kai054631/ESP32_wheel_bot/progress.md

# Progress Log

## 2026-08-08 — Course started
- Set up course scope, hardware (ESP32-S3 + GY-85 + TB6612 + 2 motors w/ encoders, diff drive), toolchain (PlatformIO), teaching style (Socratic/guided lookup).
- Stage 1 goal defined: fused pose (x, y, θ) estimate from encoders + IMU.
- Toolchain switched to native ESP-IDF (already installed) instead of PlatformIO.
- Board: ESP32-S3-DevKitC clone, two USB-C ports — one wired to the S3's native USB peripheral (idVendor=303a, "USB JTAG/serial debug unit"), one to an onboard WCH USB-serial chip (idVendor=1a86, PID 55d3, "USB Single Serial").
- **Gotcha found & fixed:** `/dev/ttyACM*` never appeared on either port because `cdc_acm` was blacklisted system-wide in `/etc/modprobe.d/blacklist-qcserial.conf` (leftover from [[jz01-openstick-flash]], now finished). Removed the `blacklist cdc_acm` line, `sudo modprobe cdc_acm` — `/dev/ttyACM0` now appears (bound to the 1a86:55d3 WCH chip's port; ch341/ch343 drivers were never actually needed since cdc_acm's alias table already covers that PID).
- Found existing half-done work at ~/Documents/PlatformIO/Projects/wheel_robot: a PlatformIO/Arduino project (platformio.ini targets esp32-s3-devkitc1-n8r8) with src/main.cpp already declaring TB6612 pins (PWMA=4, AIN2=5, AIN1=6, STBY=7, BIN1=15, BIN2=16, PWMB=17, GND=18), encoder pins (enAA=8, enAB=3, enBA=46, enBB=9), and GY-85 I2C pins (sda=11, scl=10) — motor speed/interrupt code commented out, nothing implemented yet. Also had a cloned reference repo `esp-idf-gy85` nested inside it (ready-made ADXL345/ITG3200/HMC5883L/I2Cdev drivers + MadgwickAHRS/Kalman fusion, WiFi streaming examples).
- Decision: redo firmware in native ESP-IDF (porting the pin assignments above, not the Arduino code itself); esp-idf-gy85 set aside as an answer-key only, not to be copied from directly — GY-85 drivers to be written from scratch in Modules 2–3.
- Moved everything into the course folder: `~/robot_learner/reference/wheel_robot_platformio/` (old project) and `~/robot_learner/reference/esp-idf-gy85/` (reference repo).
- Next: Module 0 continued — create a fresh ESP-IDF hello_world project (e.g. `~/robot_learner/firmware/`) and verify `idf.py build/flash/monitor` round-trip on /dev/ttyACM0.

## 2026-08-08 (cont.) — Tutorial series planning
- User asked for a 1-by-1 tutorial series (60-90 min each) ending in the robot driving as a 2-wheel differential robot, before localization work.
- Plan written and approved: reorders syllabus to drive-first — T1 ESP-IDF bring-up, T2 wiring/pin/power audit, T3 TB6612+LEDC per-wheel, T4 open-loop drive(v,ω) [robot runs = milestone], T5 encoders (PCNT), T6 tick→metres calibration, T7 closed-loop PI + square capstone. IMU/GY-85/fusion deferred to after T7.
- **Finding: ESP-IDF was never actually installed on this Linux box.** VS Code Espressif extension present but its globalStorage never initialized; settings.json had stale Windows paths (d:\ESPTOOLS\...) synced from another machine; only export.sh on disk belongs to PlatformIO's bundled framework-espidf (not to be reused as IDF_PATH — it's stripped down). Cleared the stale idf.pythonInstallPath/idf.gitPathWin keys from settings.json (backup at settings.json.bak-robotlearner).
- Started headless install via `~/.espressif/eim_gui/eim install -t esp32s3 -i v5.3.2` (this is infra, driven by tutor not Socratic). First attempt failed: missing system prereqs flex/bison/gperf/ccache. Wrote `fix_idf_prereqs.sh` (apt install, needs sudo) for user to run themselves.
- Next: user runs fix_idf_prereqs.sh, then re-launch eim install in background; once idf.py --version works, write and hand over Tutorial 1 (~/robot_learner/tutorials/t01-*.html).

## 2026-08-09 — ESP-IDF install running
- User ran fix_idf_prereqs.sh: flex/bison/gperf/ccache confirmed installed via dpkg.
- Relaunched `eim install -t esp32s3 -i v5.3.2 -n true --cleanup true` in background (log: idf_install.log). Prereqs check passed, mirrors selected (github.com, pypi.org), cloning esp-idf v5.3.2 now.
- Board currently unplugged (no /dev/ttyACM0) — not blocking, install doesn't need the board.
- Next: poll idf_install.log until done, verify `idf.py --version`, then write Tutorial 1 HTML page.

## 2026-08-09 (cont.) — ESP-IDF install finished, Tutorial 1 unblocked
- eim install completed successfully: "You have successfully installed ESP-IDF" (ESP-IDF v5.3.2, esp32s3 target, ~5.5 min total).
- Verified: `source ~/.espressif/tools/activate_idf_v5.3.2.sh` then `idf.py --version` → "ESP-IDF v5.3.2-dirty" (dirty suffix is harmless, normal for shallow submodule clone). IDF_PATH set correctly.
- One non-fatal install error: couldn't copy OpenOCD udev rules to /etc/udev/rules.d (needs sudo) — irrelevant for now (flashing over WCH UART/cdc_acm, not JTAG); revisit only if JTAG debugging is needed later.
- Tutorial 1 (~/robot_learner/tutorials/t01-esp-idf-bringup.html) is now fully unblocked — toolchain ready, board at /dev/ttyACM0 (when plugged in).

## 2026-08-15 → 2026-09-05 — Firmware stages and the new PCB (from git log)
- 08-15 initial backup of firmware, tutorials, docs, PCB snapshot. Tutorials in the repo: t01, t05–t08 (t02–t04 are not there).
- 08-23 `GY85_Check`: I2C bring-up, then live data from all three sensors. The "magnetometer" is a QMC5883L clone (address 0x0D), not an HMC5883L.
- 08-31 `Motor_Drive_With_IDF` tried on DRV8833, then went back to TB6612FNG on the new board.
- 09-05 combined bring-up test on the new PCB pinout: both motors both ways, both encoders, GY-85 live data, battery voltage sense. Pin map is in `pins.txt`.

## 2026-10-15 — Encoders to 4x, PWM→rpm table, first P speed control
Code lives in `firmware/Motor_Drive_With_IDF/main/main.c` (main checkout, not committed yet).
- **Encoder was only 2x decode.** Each PCNT unit had one channel. Hand-turning the wheel one turn gave ~957 ticks (expected 990 = 11 PPR × 2 × 45). Fix: a second channel per motor on the same unit (edge/level pins swapped). Rule: both channels of a motor use level action (KEEP, INVERSE); their edge actions are swapped; motor B is mirrored so its actions are the opposite of motor A.
- Motor A now gives **1980 ticks per wheel turn** (11 PPR × 4 × 45), checked by hand. Motor B has the same two-channel setup and moved in the same direction as A; its ticks per turn were not reported — **still to verify**.
- Encoder pins are swapped in the `#define`s (A: 11/10, B: 13/12) so forward counts **positive**. The names still say "phase A/B" — they are swapped on purpose.
- Speed: `rpm = delta / 0.02 s / 1980 × 60`, `m/s = rpm × π × 0.065 / 60`. One tick per 20 ms is **1.5 rpm**, so steady readings jump by about ±1.5–2.5 rpm. That is quantisation, not instability.
- **PWM → rpm, wheel in the air, 12.55 V** (steps of 5 %): 0, 5, 10 % → 0 rpm; 15 % → 21.2; 30 % → 50; 50 % → 89.4; 75 % → 137.9; 100 % → 190.9 rpm (0.649 m/s). Dead zone is between 10 and 15 %. Line fit above the dead zone: **rpm ≈ 2.01 × PWM − 9.9** (check: 50 % gives 90.5, measured 89.4). The `rpm/pwm` column is not constant because of the negative offset; the slope is. Floor (loaded) table not measured yet.
- **Battery sense** (GPIO14, ADC2 ch3): divider 100k/22k → ×5.545. The plain `raw/4095 × 3.3 × 5.545` read about 8 % low (10.5 V on an 11.5 V pack, 11.59 V on 12.6 V). A gain of **1.09** fixes it to about ±0.05 V. The IDF curve-fit calibration (used in the 09-05 test) is still the better option.
- **Serial gotcha:** the native USB port (303a, "USB JTAG serial debug unit") is output-only (console is UART0 with USB-JTAG as secondary). Keyboard input in `idf.py monitor` only works on the other USB port (WCH, 1a86). "Writing to serial is timing out" means wrong port.
- **P control with feed-forward:** `pwm = (target + 9.9) / 2.01 + Kp × (target − rpm)`. Hold-the-wheel-then-release test at 40 rpm, 20 ms per line:
  - Kp 0.35: 36 rpm after ~80 ms, no real overshoot.
  - Kp 0.7: ~100 ms, no real overshoot.
  - Kp 1.0: ~80 ms, but overshoots to 45.5 rpm (~14 %) and rings for ~160 ms.
  - Use **Kp ≈ 0.5**. Loop gain = Kp × 2.01; above ~1 you get overshoot. A bigger Kp also makes the 1-tick noise bigger.
  - With the wheel in the air the feed-forward is already almost exact, so the steady error is < 1 rpm. Under load P-only will leave an error → add the I term (t08).
- Two false alarms: the "restart at PWM ≥ 45" was a key press (`0` set PWM to 0), not a reset. The random GPIO 48 RGB LED is a floating pin (not fixed yet: set it as output, low).
- **Open items:** verify motor B (1980 per turn, sign of +PWM vs +rpm — if opposite, the loop runs away), measure the PWM→rpm table on the floor, PI controller (t08), battery check (read every cycle, hysteresis, command 0 when low instead of sleeping), wrap handling for the PCNT counter (±32767, ~5 s at full speed), tidy `main.c` (per-motor struct, named constants, `motor.c/h`).

## 2026-10-16 to 2026-10-25 — Speed loop in motor.c, odometry, Wi-Fi, live map
Code is in `firmware/Motor_Drive_With_IDF/main/`. Style rule from 2026-10-25: write English in ASD-STE100.

**Speed loop (motor.c, motor.h)**
- `motor_t` holds the pins, the PCNT unit, and the state of one motor. `motor_drive()` replaces the two copies of `motorMove`.
- `motor_update()` does the full cycle: read the count, handle the PCNT wrap, calculate rpm, add feed-forward, P, and I terms, clamp, lift the dead zone, and drive the motor.
- Feed-forward: `(|target| + 9.9) / 2.01`, with the sign of the target. Negative targets work.
- Dead zone: a PWM value between 0 and 15 (or between -15 and 0) is set to 15 (or -15).
- The integral clamp is ±10. A clamp of ±30 gave an 80 % overshoot at start-up.
- `motor_kp` and `motor_ki` are shared globals (one set of gains for both motors).
- Motor A is the LEFT wheel. Motor B is the RIGHT wheel. The names follow the PCB silkscreen. Both encoders give 1980 ticks per turn.
- A target of 20 rpm or less is limited by the dead zone. The wheel cannot hold a speed below about 21 rpm.

**Odometry (odom.c, odom.h)**
- One tick is `pi * D / 1980` m. The wheel diameter D is 68.5 mm (measured). The old code used 65 mm.
- `d = (dL + dR) / 2` and `dtheta = (dR - dL) / L`. The code uses the new theta to update x and y.
- Test: a 300 mm push read 311 mm (3.7 % too high). After more tests the distance is accurate. Heading drift was small (y = 2 mm, theta = -0.4 deg).

**Wi-Fi (net.c, net.h)**
- Wi-Fi station mode plus one TCP server on port 3333. The robot serves ONE client only.
- `net_printf()` and `net_getc()` do not block. The control loop never waits for the network.
- The Wi-Fi name and password are in `wifi_secret.h`. This file is in `.gitignore`. Do not commit it.
- Warning: ADC2 (battery sense, GPIO 14) and Wi-Fi share hardware. `adc_oneshot_read` can return `ESP_ERR_TIMEOUT`. The code must not stop on this error.

**Live map (tools/robot_map.py)**
- It reads the Odom lines from the TCP stream. It draws the trail and the robot outline on an x-y map.
- Keys w, a, s, d, and space go to the robot. Use this tool instead of `nc`.
- Run `python3 tools/robot_map.py --demo` to test it without the robot.

**Robot size (measured 2026-10-25)**
- Width over the outer faces of the wheels: 209 mm. Gap between the wheels: 157 mm.
- Each wheel is 26 mm wide. The track width (centre to centre) is therefore 157 + 26 = **183 mm**.
- Length: 213 mm. The drive wheels are at the front. The dead (caster) wheel is at the rear.
- The odometry point is the midpoint of the drive axle.
- `TRACK_WIDTH` in `odom.h` was 0.157 (the gap, not the track width). Change it to 0.183. Then calibrate: turn the robot one full turn on the floor. The theta reading must be 360 deg.
- A turn on the spot sweeps the rear of the robot through a circle of about 0.5 m diameter.

**Open items**
1. Dead-man timeout: the robot must stop when no key arrives (use 0.7 s).
2. `drive(v, omega)`, the `D` and `T` commands (go a distance, turn an angle), and the `p0.01` command (set Kp).
3. Handle the ADC2 error when Wi-Fi is on.
4. Calibrate `TRACK_WIDTH` on the floor (3 turns, take the average).
5. Measure the PWM-to-rpm table on the floor.

## 2026-10-25 (later) — Track width calibration, first results
Goal: find the effective track width L. The odometry uses `dtheta = (dR - dL) / L`. A wrong L gives a wrong turn angle by the same ratio.

**Measured sizes:** the gap between the wheels is 157 mm. Each wheel is 26 mm wide. So the track width from the sizes is 183 mm. The code first used `TRACK_WIDTH 0.1832`.

**Test 1: A = 35 rpm, B = 0 (left wheel drives, robot turns clockwise around the right wheel). Odometry was reset.**
- The robot turned about one full turn (set by eye). The theta reading was **-378.1 deg**. The position was x = 0.029 m, y = 0.005 m.
- Check: the robot turned 18 deg more than one turn. The center then moves `L * sin(9 deg) = 0.1832 * 0.156 = 0.029 m`. This matches x. The odometry is consistent inside.

**Test 2: B = 35 rpm, A = 0 (right wheel drives, robot turns counter-clockwise around the left wheel). Odometry was NOT reset.**
- The reading after the test was theta = -6.6 deg, x = 0.047 m, y = 0.009 m.
- Theta adds up over time. So this turn read -6.6 - (-378.1) = **+371.5 deg**.
- Check: the robot turned 11.5 deg more than one turn. The center moved by `L * sin(5.75 deg) = 0.018 m`. The measured change was (0.018, 0.004) m. This matches.
- The sign of y is opposite to the ideal calculation, by about 4 mm. The wheel that should not move probably rolls a little. This is small.

**Result (L = 0.1832 in both tests, one run each, one turn judged by eye):**

| Test | Reading | Ratio to 360 deg |
|---|---|---|
| Test 1, clockwise | 378.1 deg | 1.050 |
| Test 2, counter-clockwise | 371.5 deg | 1.032 |
| Mean | 374.8 deg | 1.041 |

- New L = 0.1832 * 1.041 = **0.1907 m**. `TRACK_WIDTH` is now set to **0.19**.
- Formula: `L_new = L_old * (reading / real angle)`. If the reading is too large, L is too small.
- The effective L (about 190 mm) is larger than the size from the ruler (183 mm). The contact area of the tire is probably at the outer side of the wheel. The dead wheel also drags and adds some slip.
- The two directions differ by 1.8 %. It can come from the error of the eye (3 to 5 deg), or from wheel slip. One run each cannot tell which.

**Rules for the next test**
1. Reset the odometry before each test. Press the EN (reset) button.
2. Put the dead wheel straight at the rear before each start.
3. Do 3 runs for each direction (6 runs). Use the same mark on the robot to judge one turn.
4. Take the mean of all runs. Set `TRACK_WIDTH` to `0.19 * (mean reading / 360)`.
5. Keep 0.6 m of free floor. The rear of the robot sweeps a circle of about 0.5 m diameter.

**Status:** waiting for the 6 readings with `TRACK_WIDTH = 0.19`.
**New open item:** add a key to the firmware that sets `odom` to zero (for example the `r` key). Then the EN button is not needed between tests.

## 2026-10-29 — Track width depends on the dead wheel

- The user tested with the dead (caster) wheel removed. The best `TRACK_WIDTH` is **0.181 m**.
- The size from the ruler is 0.183 m. So the two values now agree.
- With the dead wheel fitted, the best value was about 0.19 m (two sets of tests: 0.1907 and 0.191).
- Cause: the dead wheel drags and slips when the robot turns. This makes the effective track width larger.
- Rule: calibrate `TRACK_WIDTH` again each time the support at the rear changes.
- The user uses 0.181 for tests without the dead wheel.
