kai054631/ESP32_wheel_bot/guide.html

# 🤖 Robot Learning Course — Self-Localization

Teaching log for ~/robot_learner · Socratic / guided-lookup style · started 2026-08-08

MCU

ESP32-S3-DevKitC clone

IMU

GY-85 (ADXL345 + ITG3205 + HMC5883L)

Motor driver

TB6612FNG dual driver

Drive

2× DC motor w/ encoders, diff-drive

Toolchain

Native ESP-IDF (VS Code)

Serial

/dev/ttyACM0 (cdc_acm)

## Near-term goal — the robot runs

An 8-tutorial drive-first track (60–90 min each): get the robot driving open-loop as a 2-wheel differential robot first, then make it accurate with encoders and closed-loop control. IMU/GY-85 work and full pose fusion are deferred until after that.

## Stage 1 goal (after the drive-first track)

The robot maintains and reports a continuously updated estimate of its own pose — (x, y, θ) — fused from wheel-encoder odometry and the GY-85 IMU.
"It knows where it is" means it can print/log this estimate in real time.

## Tutorials — drive-first track

1. T1
  ESP-IDF project & flash round-trip
  60–75 min · idf.py build/flash/monitor round-trip on /dev/ttyACM0. Open tutorial →
2. T2
  Wiring audit, pin map & power topology
  60–75 min · done informally via code review (GPIO18 fake-ground caught & fixed in hardware). pinmap.md still not written formally.
3. T3
  TB6612 + LEDC: one wheel, then two
  75–90 min · motorMove(mot, value), independent LEDC channels per motor, both directions, deadband/scale fixed.
4. T4
  drive(v, ω) open loop robot runs here
  75–90 min · differential-drive kinematics → duty. Drives, reverses, pivots, arcs on command. Open tutorial → (page numbered T7, sequence renumbering pending — see note below)
5. T5
  Wheel encoders via PCNT current
  75–90 min · quadrature tick counting with the current driver/pulse_cnt.h API, correct sign per direction. Open tutorial →
6. T6
  Ticks → metres and m/s
  75–90 min · empirically derive counts/rev, wheel diameter; distance and speed within a few % of a tape measure. Open tutorial →
7. T7
  drive(v, ω): inverse kinematics
  75–90 min · (v, ω) → per-wheel duty, with saturation handled correctly. Forward kinematics/odometry (ticks → x,y,θ) is deferred. Open tutorial →
8. T8
  Closed-loop PI + capstone
  90 min · per-wheel PI speed control (anti-windup, output clamping, 1000 Hz tick + vTaskDelayUntil), drives straight, completes a 1 m square. Open tutorial →

Numbering note: motor work (T2–T4) happened out of order, driven by code the user wrote ahead of the tutorials, and was resolved through review rather than standalone pages — see ~/.claude/plans/wild-puzzling-map.md for that history. The four new pages (encoders → speed/distance → inverse kinematics → closed-loop PI) are files t05–t08 on disk; this list's T4/T7 numbering is being kept provisional rather than renumbered until the whole sequence is renumbered at once.

## Full syllabus (after the robot runs)

1. A
  I2C bus & GY-85 raw comms
  I2C scan, register-level reads from ADXL345 / ITG3205 / HMC5883L.
2. B
  Sensor calibration & units
  Counts → g / °/s / heading, gyro bias, hard/soft-iron basics.
3. C
  IMU-based heading
  Gyro integration, complementary/Kalman fusion with magnetometer heading.
4. D
  Sensor fusion for pose
  Combine encoder (x, y) with IMU-corrected heading into one pose estimate.
5. E
  Stretch: logging / visualization / EKF
  Plot the driven path, discuss a proper EKF framing.

Reorder note: this replaces the original modules 1–9 in syllabus.md, which interleaved GY-85 work before motors. The drive-first track promotes motor/encoder work so the robot moves at T4; IMU/fusion work is unchanged in content, just moved after T7.

## Where we are right now — Tutorial 1

Board bring-up is done: cdc_acm was blacklisted system-wide (leftover from the JZ01 OpenStick work) — removed the blacklist line, reloaded the module, and /dev/ttyACM0 now shows up reliably.

Found an existing half-built project at ~/Documents/PlatformIO/Projects/wheel_robot (PlatformIO/Arduino, pins declared, nothing implemented) plus a cloned reference repo with ready-made GY-85 drivers. Decision: rebuild in native ESP-IDF, porting only the pin assignments; the reference repo is answer-key only. Both moved into ~/robot_learner/reference/.

✅ ESP-IDF install finished. It was never actually set up on this Linux machine — the VS Code extension had stale config synced from another computer. Fixed directly (not Socratic — infrastructure): cleared the stale settings, installed missing build prereqs (flex/bison/gperf/ccache) via a handed-off script, and ran eim install -t esp32s3 -i v5.3.2. Verified: idf.py --version → ESP-IDF v5.3.2-dirty. Tutorial 1 is fully unblocked.

The course also pivoted to a drive-first track: 7 tutorials, 60–90 min each, ending with the robot driving open-loop as a 2-wheel differential robot at T4 — before any IMU/localization work.

~/robot_learner/ ├── syllabus.md ├── progress.md ├── guide.html ← this page ├── fix_cdc_acm.sh ├── fix_idf_prereqs.sh ├── idf_install.log ESP-IDF install progress ├── tutorials/ │ └── t01-esp-idf-bringup.html ← start here └── reference/ ├── wheel_robot_platformio/ old pin assignments to port over └── esp-idf-gy85/ answer-key only — don't copy from

Next action (your turn):

1. Confirm the ESP-IDF install finished: idf.py --version in a fresh terminal.
2. Open Tutorial 1 and work through it.
3. Report back the items listed at the bottom of that tutorial before starting T2.

## Session log

2026-08-08 — Course scoped (self-localization on real hardware, not a generic ML survey). Toolchain switched from PlatformIO to native ESP-IDF. Diagnosed and fixed a system-level cdc_acm blacklist blocking serial. Found, reconciled, and relocated prior half-finished work into ~/robot_learner/reference/.

2026-08-09 — Pivoted to a 7-tutorial drive-first track (plan at ~/.claude/plans/wild-puzzling-map.md): robot drives open-loop by T4, encoders/calibration/closed-loop by T7, IMU/localization after. Discovered ESP-IDF was never actually installed here; fixed the stale extension config and prereqs, install running in background. Tutorial 1 written and handed off.

Course guide · regenerate by asking your tutor to update guide.html
