kai054631/ESP32_wheel_bot/(list of files, drawings)

Other design files:
hardware/pcb/esp32_wheel robot.eprj
