kai054631/ESP32_wheel_bot/(commit log)

2026-08-14 Initial backup: firmware, tutorials, docs, PCB snapshot
    [esp32_wheel robot.eprj]
2026-08-22 Add GY85_Check: I2C bring-up diagnostic for the GY-85 IMU
    One-shot firmware that scans the I2C bus (SDA=GPIO9, SCL=GPIO8) and
    positively identifies each expected GY-85 chip via its own ID register,
    rather than just checking whether an address ACKs.
    Findings from running this on the actual hardware:
    - ADXL345 (accel, 0x53): DEVID=0xE5, genuine chip confirmed.
    - ITG3200 (gyro, 0x68): WHO_AM_I=0x68, genuine chip confirmed.
    - HMC5883L (mag, 0x1E) did not respond; 0x0D acked instead. That's the
    QMC5883L clone's fixed address -- a common silkscreen-compatible
    substitute on cheap GY-85 boards with a different register map. This
    board's magnetometer needs a QMC5883L driver, not an HMC5883L on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
    [main.c]
2026-08-22 GY85_Check: enable and read live data from all three sensors
    Identification alone only proves a chip is present/genuine, not that
    it's actually producing fresh measurements. This adds power-up/config
    for each chip and prints 5 live samples 200ms apart:
    - ADXL345: POWER_CTL measure-mode bit set, then read DATAX0..DATAZ1.
    - ITG3200: DLPF_FS FS_SEL forced to 3 (required by datasheet regardless
    of filter setting), then read GYRO_XOUT..ZOUT.
    - QMC5883L clone (0x0D): SET/RESET period + Control Reg 1 configured for
    continuous mode/200Hz/8G/OSR512, DRDY-gated read of the data registers.
    Verified on hardware: all three report non-zero, sample-to-sample
    varying values consistent with real physic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
    [main.c]
2026-08-30 Motor_Drive_With_IDF: adapt for DRV8833 (PWM on AIN1/AIN2/BIN1/BIN2)
    - Drop PWMA/PWMB — DRV8833 has no separate PWM-enable pin per channel,
    the two IN pins themselves carry the PWM.
    - Add 4 LEDC channels (one per AIN1/AIN2/BIN1/BIN2), all on the shared
    25kHz/10-bit timer, direction set by which pin in the pair carries the
    duty and which is held low (coast-decay drive).
    - Drop the stale GPIO18 fake-GND code — pins.txt already records the
    wire moved to a real GND pin; the source never caught up until now.
    - motorMove(): correct integer duty math ((value*1023)/100, clamped to
    ±100) instead of the earlier float multiply-by-10.23.
    - Test loop in app_main: cycles A forward/stop/back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
    [main.c]
2026-09-05 Motor_Drive_With_IDF: combined bring-up test for new PCB pinout
    TB6612 motor driver (pwma4/ain2:5/ain1:6/stby:7/bin1:15/bin2:16/pwmb:17),
    encoders on 10/11 (A) and 12/13 (B), GY-85 I2C on sda:9/scl:8 (reusing the
    proven probe pattern from GY85_Check), and battery-voltage sense on GPIO14
    (ADC2 ch3, 100k/22k divider).
    Claude-Session: https://claude.ai/code/session_01Lw31hsMeySKfMJasng8Myn
2026-09-05 Motor_Drive_With_IDF: GY-85 live sensor reads + calibrated vsense
    - Added live accel/gyro/mag sampling each loop (accel+gyro from the real
    ADXL345/ITG3200, mag from the QMC5883L clone confirmed at 0x0D).
    - Vsense now uses esp_adc/adc_cali curve-fitting calibration instead of a
    naive raw*3300/4095 conversion. Verified against a multimeter: 11.37V
    logged vs 11.4V measured (was 10.76V logged vs 11.4V measured, ~5.6%
    off, before calibration).
    All four subsystems now confirmed on the new PCB: TB6612 motor driver,
    both encoders, GY-85, and vsense.
    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
2026-10-15 Docs: log Aug-Oct progress, 4x encoder + PWM table + P tuning, new-PCB pin map
    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
2026-10-15 pins.txt: keep the GPIO18 power-sequencing history and the not-audited note
    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
2026-10-16 Motor_Drive_With_IDF: 4x encoders, feed-forward + PI speed loop on both motors
    Replaces the 09-05 bring-up test with a 20 ms closed-loop speed controller:
    4x quadrature decode (1980 ticks/turn), PWM->rpm feed-forward, P + I,
    PCNT wrap handling, integral clamp, battery cut-off. Robot drove 80 cm straight.
    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
2026-10-16 Motor_Drive_With_IDF: split motor_t and motor_drive into motor.c/motor.h
    Per-motor struct (pins, LEDC channel, PCNT unit, PI state) and a single
    motor_drive(motor_t*, int) replacing the duplicated A/B motorMove. Verified on hardware.
    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
2026-10-16 Motor_Drive_With_IDF: motor_update() runs the speed loop for both motors
    Measure (4x ticks, PCNT wrap) + feed-forward + PI + clamp + dead zone moved into
    motor.c; main.c loop is now motor_update(&motorA/B). motor_kp/motor_ki are shared globals.
    Known: integral clamp (+-30) too large -> ~80% start-up overshoot; target 20 rpm is
    limited by the PWM dead zone; negative targets not supported yet.
    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
2026-10-16 Motor_Drive_With_IDF: integral clamp 30 -> 10, Ki keys 3/4
    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
2026-10-16 Motor_Drive_With_IDF: keys 5/6 change target rpm, targets set once before loop, reformat
    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
2026-10-24 Motor_Drive_With_IDF: negative targets, float target_rpm, motor A/B follow PCB marking
    ff uses |target| + sign, dead zone lift on both sides, target_rpm is float.
    Motor A/B pins swapped to match PCB silkscreen (A = left wheel); B encoder
    pins re-swapped so forward counts positive. Not yet re-tested on hardware
    after the A/B swap.
    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
2026-10-24 Motor_Drive_With_IDF: net.c/net.h - Wi-Fi station + TCP server (port 3333)
    net_init(), non-blocking net_printf()/net_getc(), net_connected(). Queues keep the
    20 ms control loop from ever waiting on the network. SSID/password live in
    wifi_secret.h (gitignored); wifi_secret.h.example is the template.
    Compiles; not yet tested on hardware and not wired into main.c.
    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
2026-10-24 Map draws the robot at true size; progress log; STE wording
    The map now shows the body (209 x 213 mm), two wheels, the rear dead wheel, and the
    heading nose. progress.md has the new entry, including the robot size and the
    track width of 183 mm (the code still has 0.157 in odom.h).
    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
2026-10-24 Firmware: odometry, Wi-Fi keys (w a s d, space = stop), track width 0.1832
    odom.c and odom.h are new. main.c reads keys from the network and runs
    motor_update() and odom_update() every 20 ms. TRACK_WIDTH is 0.1832 m.
    Not done yet: dead-man timeout, drive(v, omega), the D and T commands,
    and the ADC2 error handling when Wi-Fi is on.
    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
2026-10-24 progress.md: track width calibration results (378.1 and 371.5 deg)
    Both tests used TRACK_WIDTH 0.1832. The mean ratio is 1.041, so L is about 0.19.
    The next test uses 0.19 with 3 runs in each direction.
    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
2026-10-28 Add CLAUDE.md: working rules, commands, architecture, hardware facts
    Written in ASD-STE100 style. It covers the build and flash steps, the serial port
    rule, the Wi-Fi and TCP link, the couplings between main.c and robot_map.py,
    and the hardware facts that the code does not show.
    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
2026-10-29 Map tool: send r key (zero odometry) and restart the map at 0
    The r key was not in SEND_KEYS, so the robot never got it.
    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
2026-10-29 Docs: track width is 0.181 m without the dead wheel, about 0.19 m with it
    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
